javidambra/Control_Repe/README.md

*** Control Repe ***

  Interfaz controladora para estación repetidora de Radioaficionados
  Realiza la interfaz entre el Rx y el Tx brindando diversas funciones como:
  
  Cola y bip
  
  TOT (Time out Tx) - "Antiponcho"
  
  Identificacion
  
  Apagado remoto
  
  Entre otras

  Copyright (C) 2019-2026  Javier D'Ambra
