javidambra/Control_Repe/Hardware/Controlador_repe.pdf

BC337 | 1N⁴⁰⁰⁴ 1N⁴⁰⁰⁴ | +12V
T3 | D¹ D²

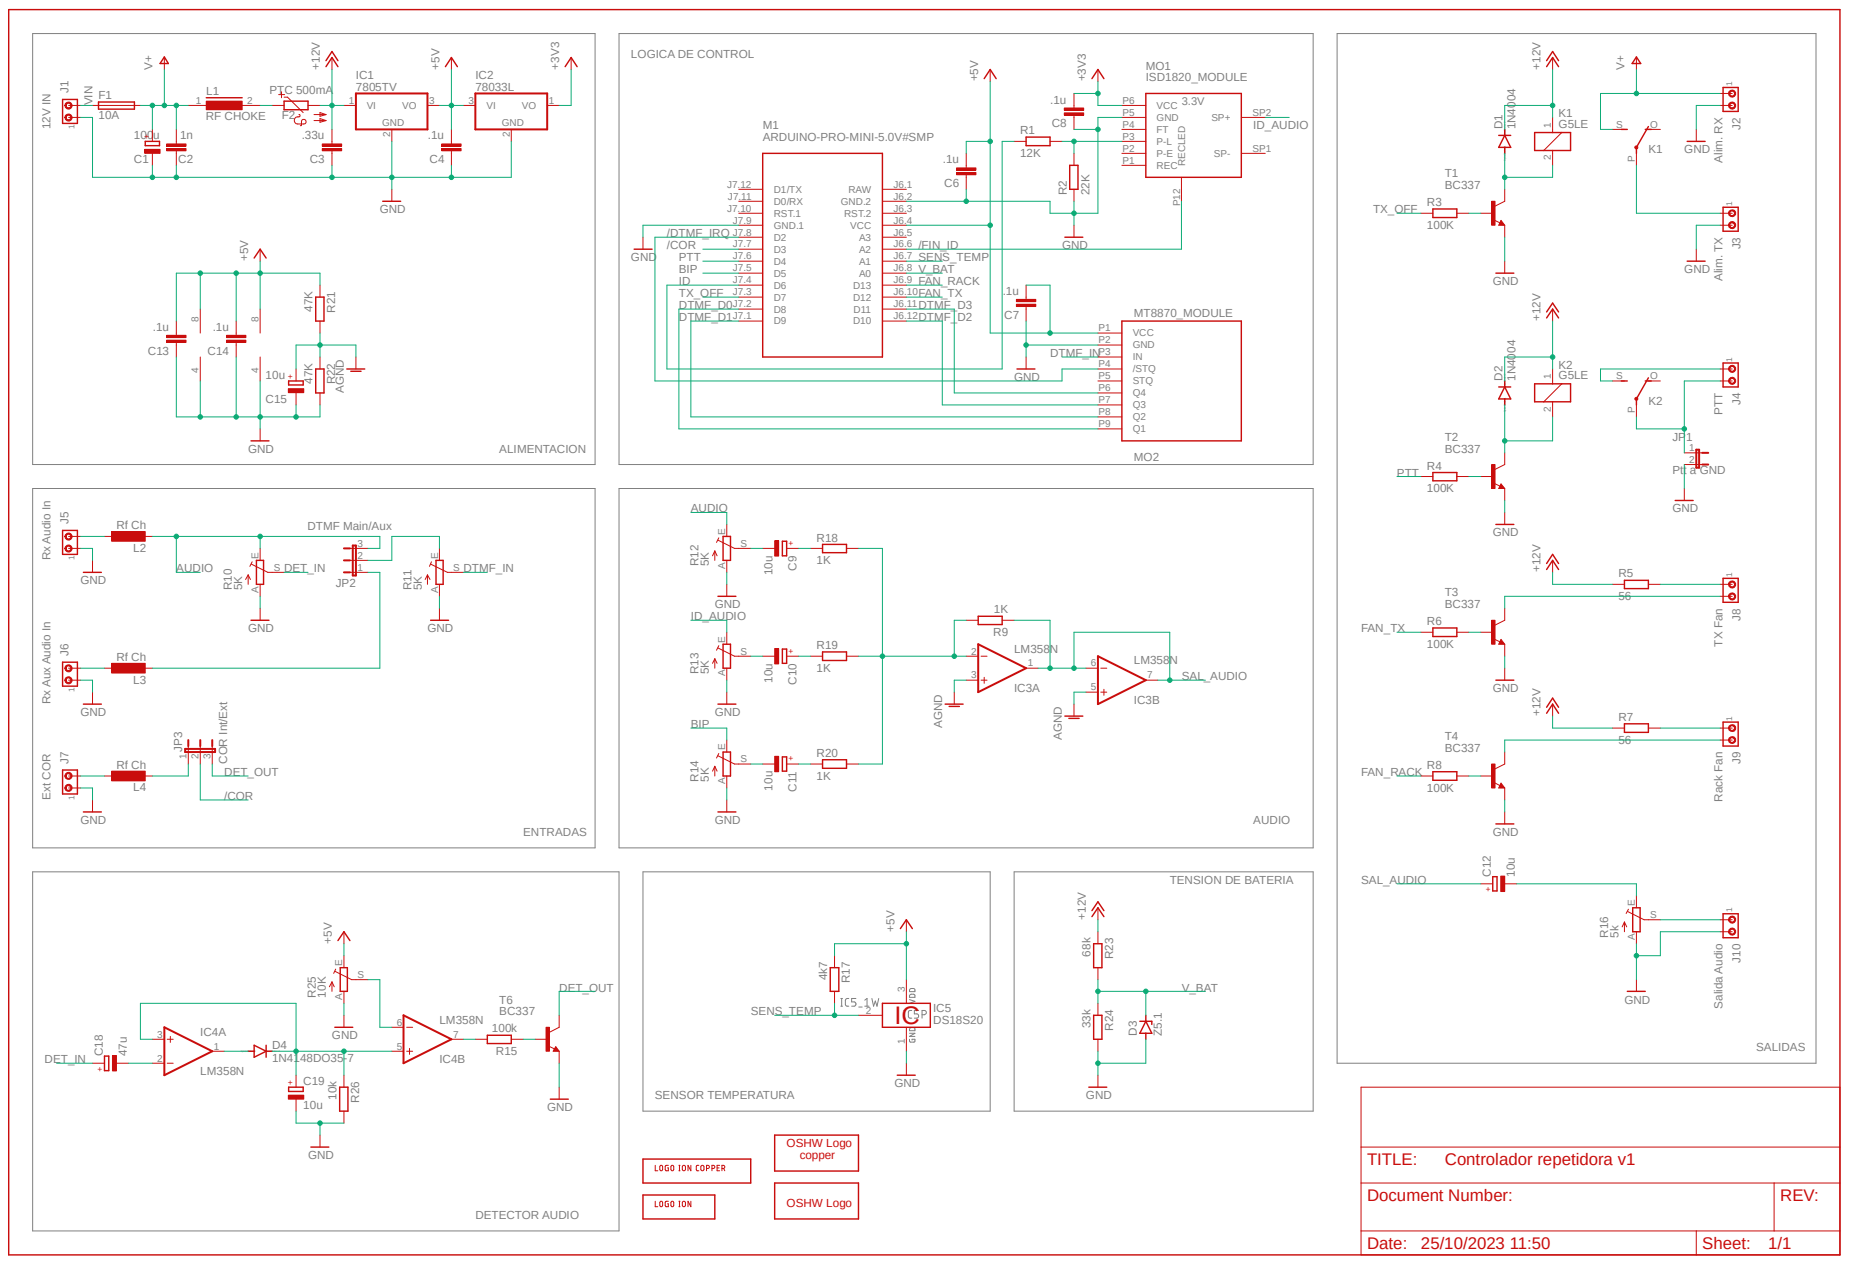
[picture p2: page 1]

ARDUINO-PRO-MINI-5.0V#SMP

SpiceOrder 1 SpiceOrder 2

GND ⁴⁷K 47K ⁺⁵V GND
