javidambra/Control_Repe/Hardware/Controlador repetidora.sch

## EAGLE design Hardware/Controlador repetidora.sch (2023-10-25)

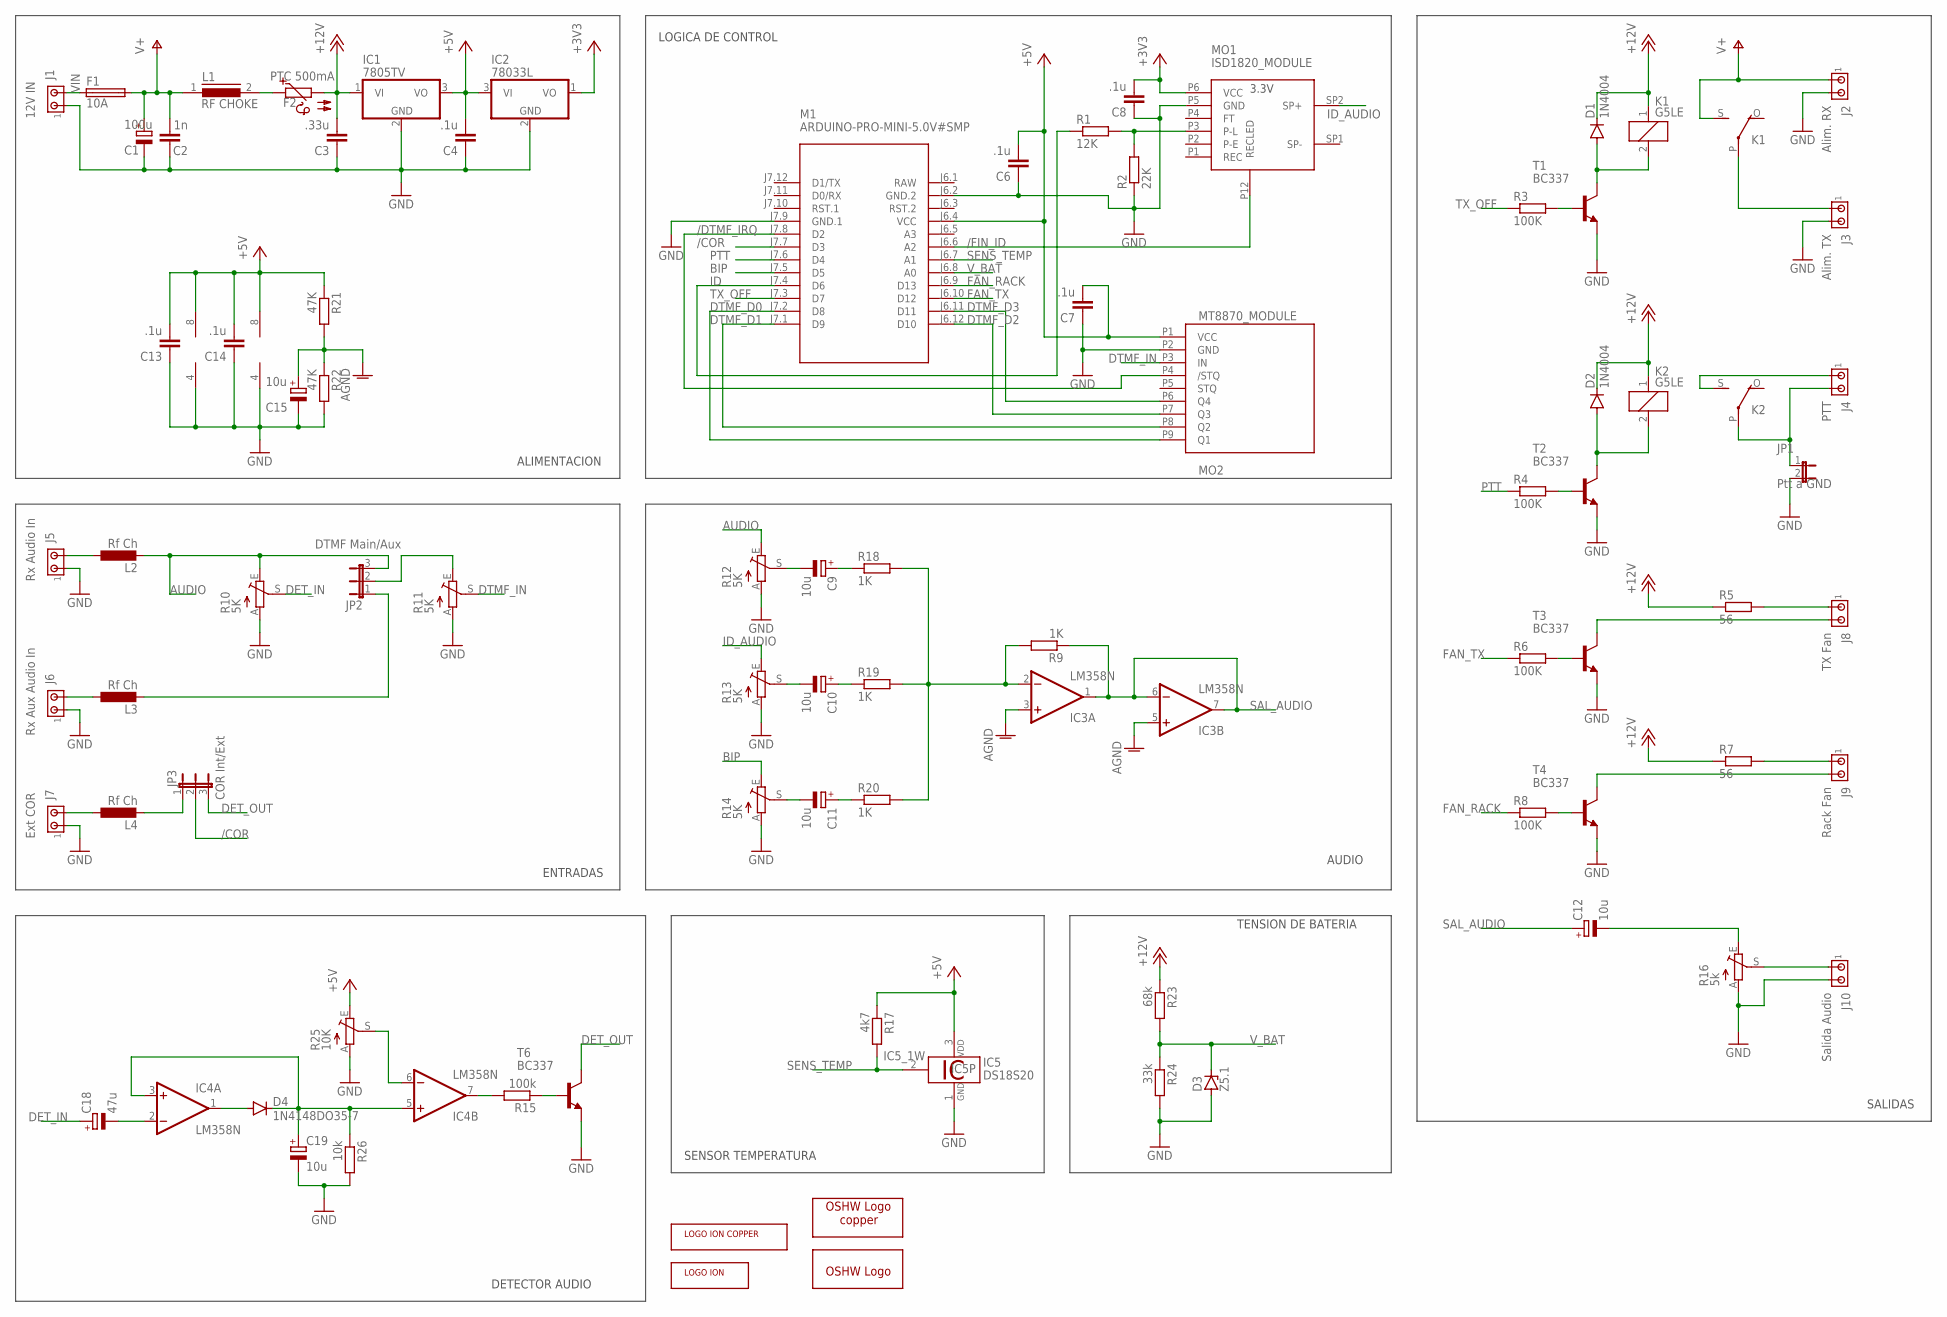
[picture p3: schematic Controlador repetidora.sch]

Parts:
C1: 100u; E2,5-7
C2: 1n; C025-025X050
C3: .33u; C025-025X050
C4, C6, C7, C8, C13, C14: .1u; C025-025X050
C9, C10, C11, C12, C15, C19: 10u; E1,8-4
C18: 47u; E1,8-4
D1, D2: 1N4004; DO41-10
D3: Z5.1; DO34Z7
D4: 1N4148DO35-7; DO35-7
F1: 10A; 19559
F2: PTC 500mA; P660A
GOLD_ORB_SM1: OSHWLOGOLOGO8MM; OSHW_8MM
GOLD_ORB_SM2: OSHWLOGO_COPPER8MM_COPPER; OSHW_8MM_COPPER
IC1: 7805TV; TO220V
IC2: 78033L; TO92
IC3, IC4: LM358N; DIL08
IC5: DS18S20; TO92-
J1: 12V IN; 1X2MTA
J2: Alim. RX; 1X2MTA
J3: Alim. TX; 1X2MTA
J4: PTT; 10X02MTA
J5: Rx Audio In; 10X02MTA
J6: Rx Aux Audio In; 10X02MTA
J7: Ext COR; 10X02MTA
J8: TX Fan; 10X02MTA
J9: Rack Fan; 10X02MTA
J10: Salida Audio; 10X02MTA
JP1: Ptt a GND; JP1
JP2: DTMF Main/Aux; JP2
JP3: COR Int/Ext; JP2
K1, K2: G5LE
L1: RF CHOKE; 82114A
L2: Rf Ch; 0207/10
L3, L4: Rf Ch; 0207/2V
M1: ARDUINO-PRO-MINI-5.0V#SMP; ARDUINO-PRO-MINI#SMP
MO1: ISD1820_MODULE
MO2: MT8870_MODULE
R1: 12K; 0207/12
R2: 22K; 0204/7
R3: 100K; 0207/10
R4: 100K; 0207/15
R5, R7: 56; 0204/7
R6, R8: 100K; 0207/2V
R9, R18, R20: 1K; 0204/7
R10, R11, R12, R13, R14: 5K; CA6H
R15: 100k; 0204/5
R16: 5k; CA6H
R17: 4k7; 0204/7
R19: 1K; 0207/5V
R21: 47K; 0204/7
R22: 47K; 0207/2V
R23: 68k; 0207/12
R24: 33k; 0204/7
R25: 10K; CA6V
R26: 10k; 0204/7
T1, T2, T3, T4, T6: BC337; TO92
U$1: LOGO_ION; LOGO_ION_SILK
U$2: LOGO_ION_COOPER; LOGO_ION_COPPER

Connections:
+3V3: C8.2, IC2.1 (VO), MO1.P6 (VCC)
+5V: C4.2, C6.2, C7.2, C13.2, C14.2, IC1.3 (VO), IC2.3 (VI), IC3.8 (V+), IC4.8 (V+), IC5.3 (VDD), M1.J6.4 (VCC), MO2.P1 (VCC), R17.1, R21.1, R25.E
+12V: C3.2, D1.C, D2.C, F2.2, IC1.1 (VI), K1.1, K2.1, R5.1, R7.1, R23.1
/COR: JP3.2, M1.J7.7 (D3)
/DTMF_IRQ: M1.J7.8 (D2), MO2.P4 (/STQ)
/FIN_ID: M1.J6.6 (A2), MO1.P12 (RECLED)
AGND: C15.+, IC3.3 (+IN), IC3.5 (+IN), R21.2, R22.1
AUDIO: JP2.3, L2.2, R10.E, R12.E
BIP: M1.J7.5 (D5), R14.E
DET_IN: C18.+, R10.S
DET_OUT: JP3.3, T6.3 (C)
DTMF_D0: M1.J7.2 (D8), MO2.P9 (Q1)
DTMF_D1: M1.J7.1 (D9), MO2.P8 (Q2)
DTMF_D2: M1.J6.12 (D10), MO2.P7 (Q3)
DTMF_D3: M1.J6.11 (D11), MO2.P6 (Q4)
DTMF_IN: MO2.P3 (IN), R11.S
FAN_RACK: M1.J6.9 (D13), R8.1
FAN_TX: M1.J6.10 (D12), R6.1
GND: C1.-, C2.1, C3.1, C4.1, C6.1, C7.1, C8.1, C13.1, C14.1, C15.-, C19.-, D3.A, IC1.2 (GND), IC2.2 (GND), IC3.4 (V-), IC4.4 (V-), IC5.1 (GND), J1.1, J2.2, J3.2, J5.1, J6.1, J7.1, J10.2, JP1.2, M1.J6.2 (GND.2), M1.J7.9 (GND.1), MO1.P5 (GND), MO2.P2 (GND), R2.1, R10.A, R11.A, R12.A, R13.A, R14.A, R16.A, R22.2, R24.2, R25.A, R26.2, T1.1 (E), T2.1 (E), T3.1 (E), T4.1 (E), T6.1 (E)
ID: M1.J7.4 (D6), R1.1
ID_AUDIO: MO1.SP2 (SP+), R13.E
unnamed: MO1.P3 (P-L), R1.2, R2.2
unnamed: D1.A, K1.2, T1.3 (C)
unnamed: J3.1, K1.P
unnamed: D2.A, K2.2, T2.3 (C)
unnamed: J5.2, L2.1
unnamed: J4.2, JP1.1, K2.P
unnamed: J4.1, K2.S
unnamed: R4.2, T2.2 (B)
unnamed: R3.2, T1.2 (B)
unnamed: J8.1, R5.2
unnamed: J8.2, T3.3 (C)
unnamed: J9.1, R7.2
unnamed: R6.2, T3.2 (B)
unnamed: F2.1, L1.2
unnamed: J9.2, T4.3 (C)
unnamed: R8.2, T4.2 (B)
unnamed: IC3.2 (-IN), R9.2, R18.2, R19.2, R20.2
unnamed: JP2.2, R11.E
unnamed: C9.-, R12.S
unnamed: C9.+, R18.1
unnamed: J6.2, L3.1
unnamed: JP2.1, L3.2
unnamed: J7.2, L4.1
unnamed: JP3.1, L4.2
unnamed: C10.-, R13.S
unnamed: C10.+, R19.1
unnamed: C11.-, R14.S
unnamed: C11.+, R20.1
unnamed: IC4.7 (OUT), R15.2
unnamed: J10.1, R16.S
unnamed: R15.1, T6.2 (B)
unnamed: C12.-, R16.E
unnamed: C18.-, IC4.2 (-IN)
unnamed: C19.+, D4.C, IC4.3 (+IN), IC4.5 (+IN), R26.1
unnamed: IC4.6 (-IN), R25.S
unnamed: D4.A, IC4.1 (OUT)
PTT: M1.J7.6 (D4), R4.1
SAL_AUDIO: C12.+, IC3.1 (OUT), IC3.6 (-IN), IC3.7 (OUT), R9.1
SENS_TEMP: IC5.2 (1W), M1.J6.7 (A1), R17.2
TX_OFF: M1.J7.3 (D7), R3.1
V+: C1.+, C2.2, F1.2, J2.1, K1.S, L1.1
VIN: F1.1, J1.2
V_BAT: D3.C, M1.J6.8 (A0), R23.2, R24.1

Notes on the sheet:
ALIMENTACION
LOGICA DE CONTROL
SALIDAS
ENTRADAS
AUDIO
DETECTOR AUDIO
SENSOR TEMPERATURA
TENSION DE BATERIA
